marianobilli/bluetooth-radio-manager/hardware/Radio-module-NRF24L01-PA-LNA-with-antenna-Packaging-status-original.jpg

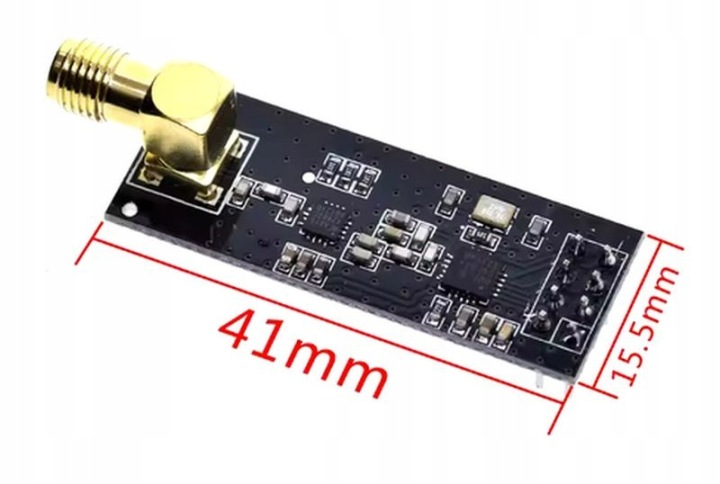
hardware/Radio-module-NRF24L01-PA-LNA-with-antenna-Packaging-status-original.jpg
