marianobilli/bluetooth-radio-manager/images/board-underside.png

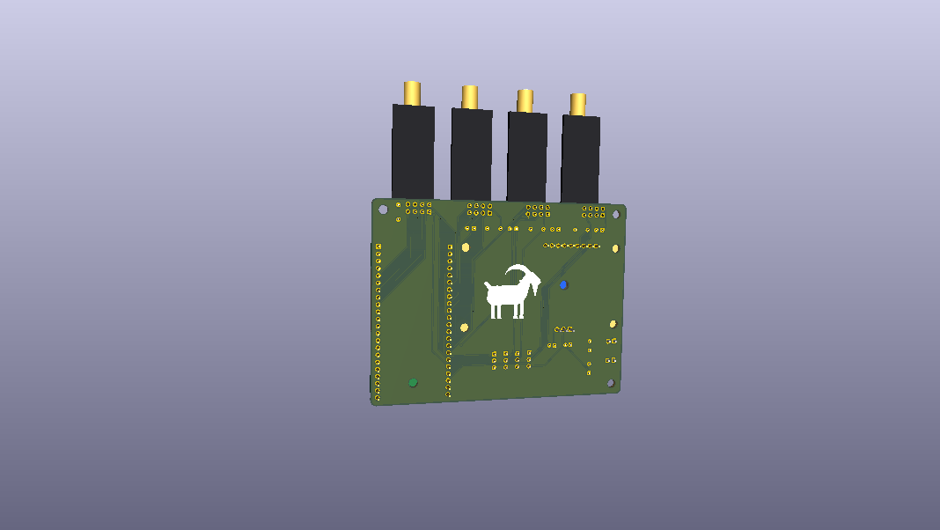
images/board-underside.png
