marianobilli/bluetooth-radio-manager/images/ebyte e01.png

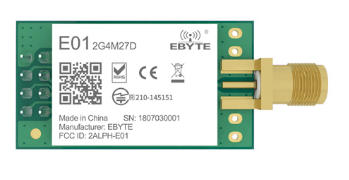
images/ebyte e01.png
