marianobilli/bluetooth-radio-manager/images/usb-port-for-case.png

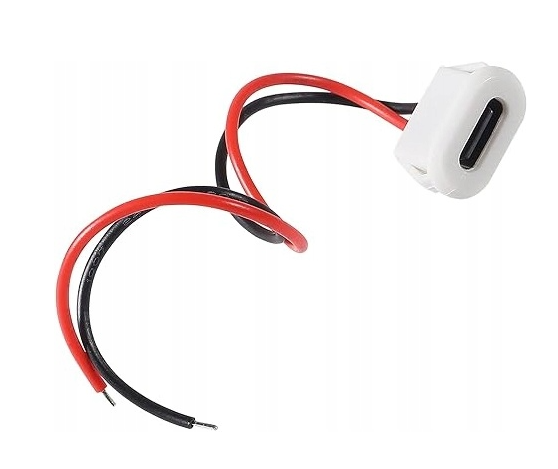
images/usb-port-for-case.png
