marianobilli/bluetooth-radio-manager/case/print/enclosure_lid.step

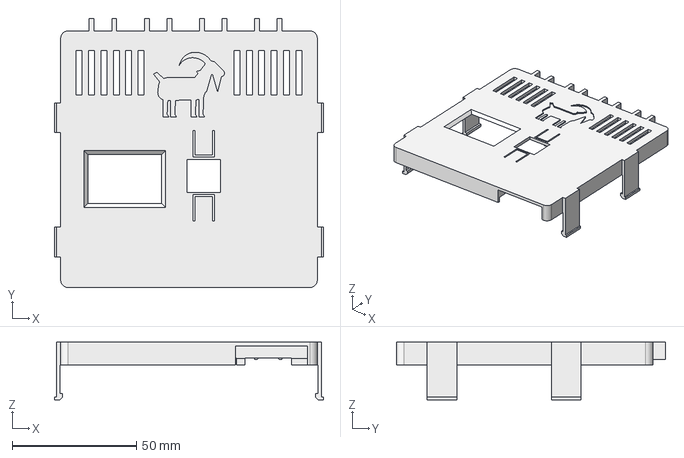
[picture p10: CAD file, 2026-10-19]
case/print/enclosure_lid.step
108.3 x 108.3 x 23.2 mm
