marianobilli/bluetooth-radio-manager/case/print/enclosure_base.step

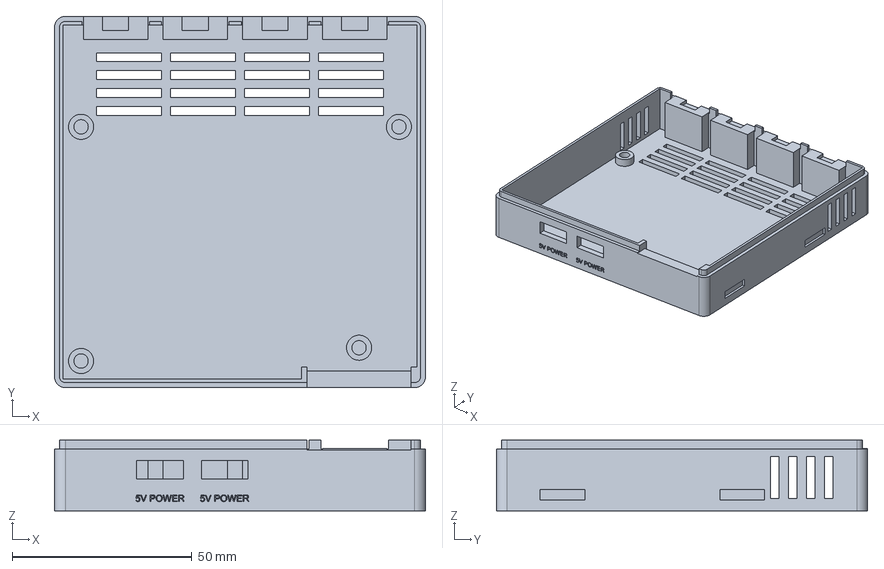
[picture p11: CAD file, 2026-10-19]
case/print/enclosure_base.step
103.3 x 103.3 x 19.7 mm
