marianobilli/bluetooth-radio-manager/(list of files, cad)

Other CAD files:
case/print/enclosure_base.stl
case/print/enclosure_lid.stl
