marianobilli/bluetooth-radio-manager/hardware/kicad/bt_radio_manager.kicad_pcb

## KiCad design hardware/kicad/bt_radio_manager.kicad_pcb (2026-10-15)

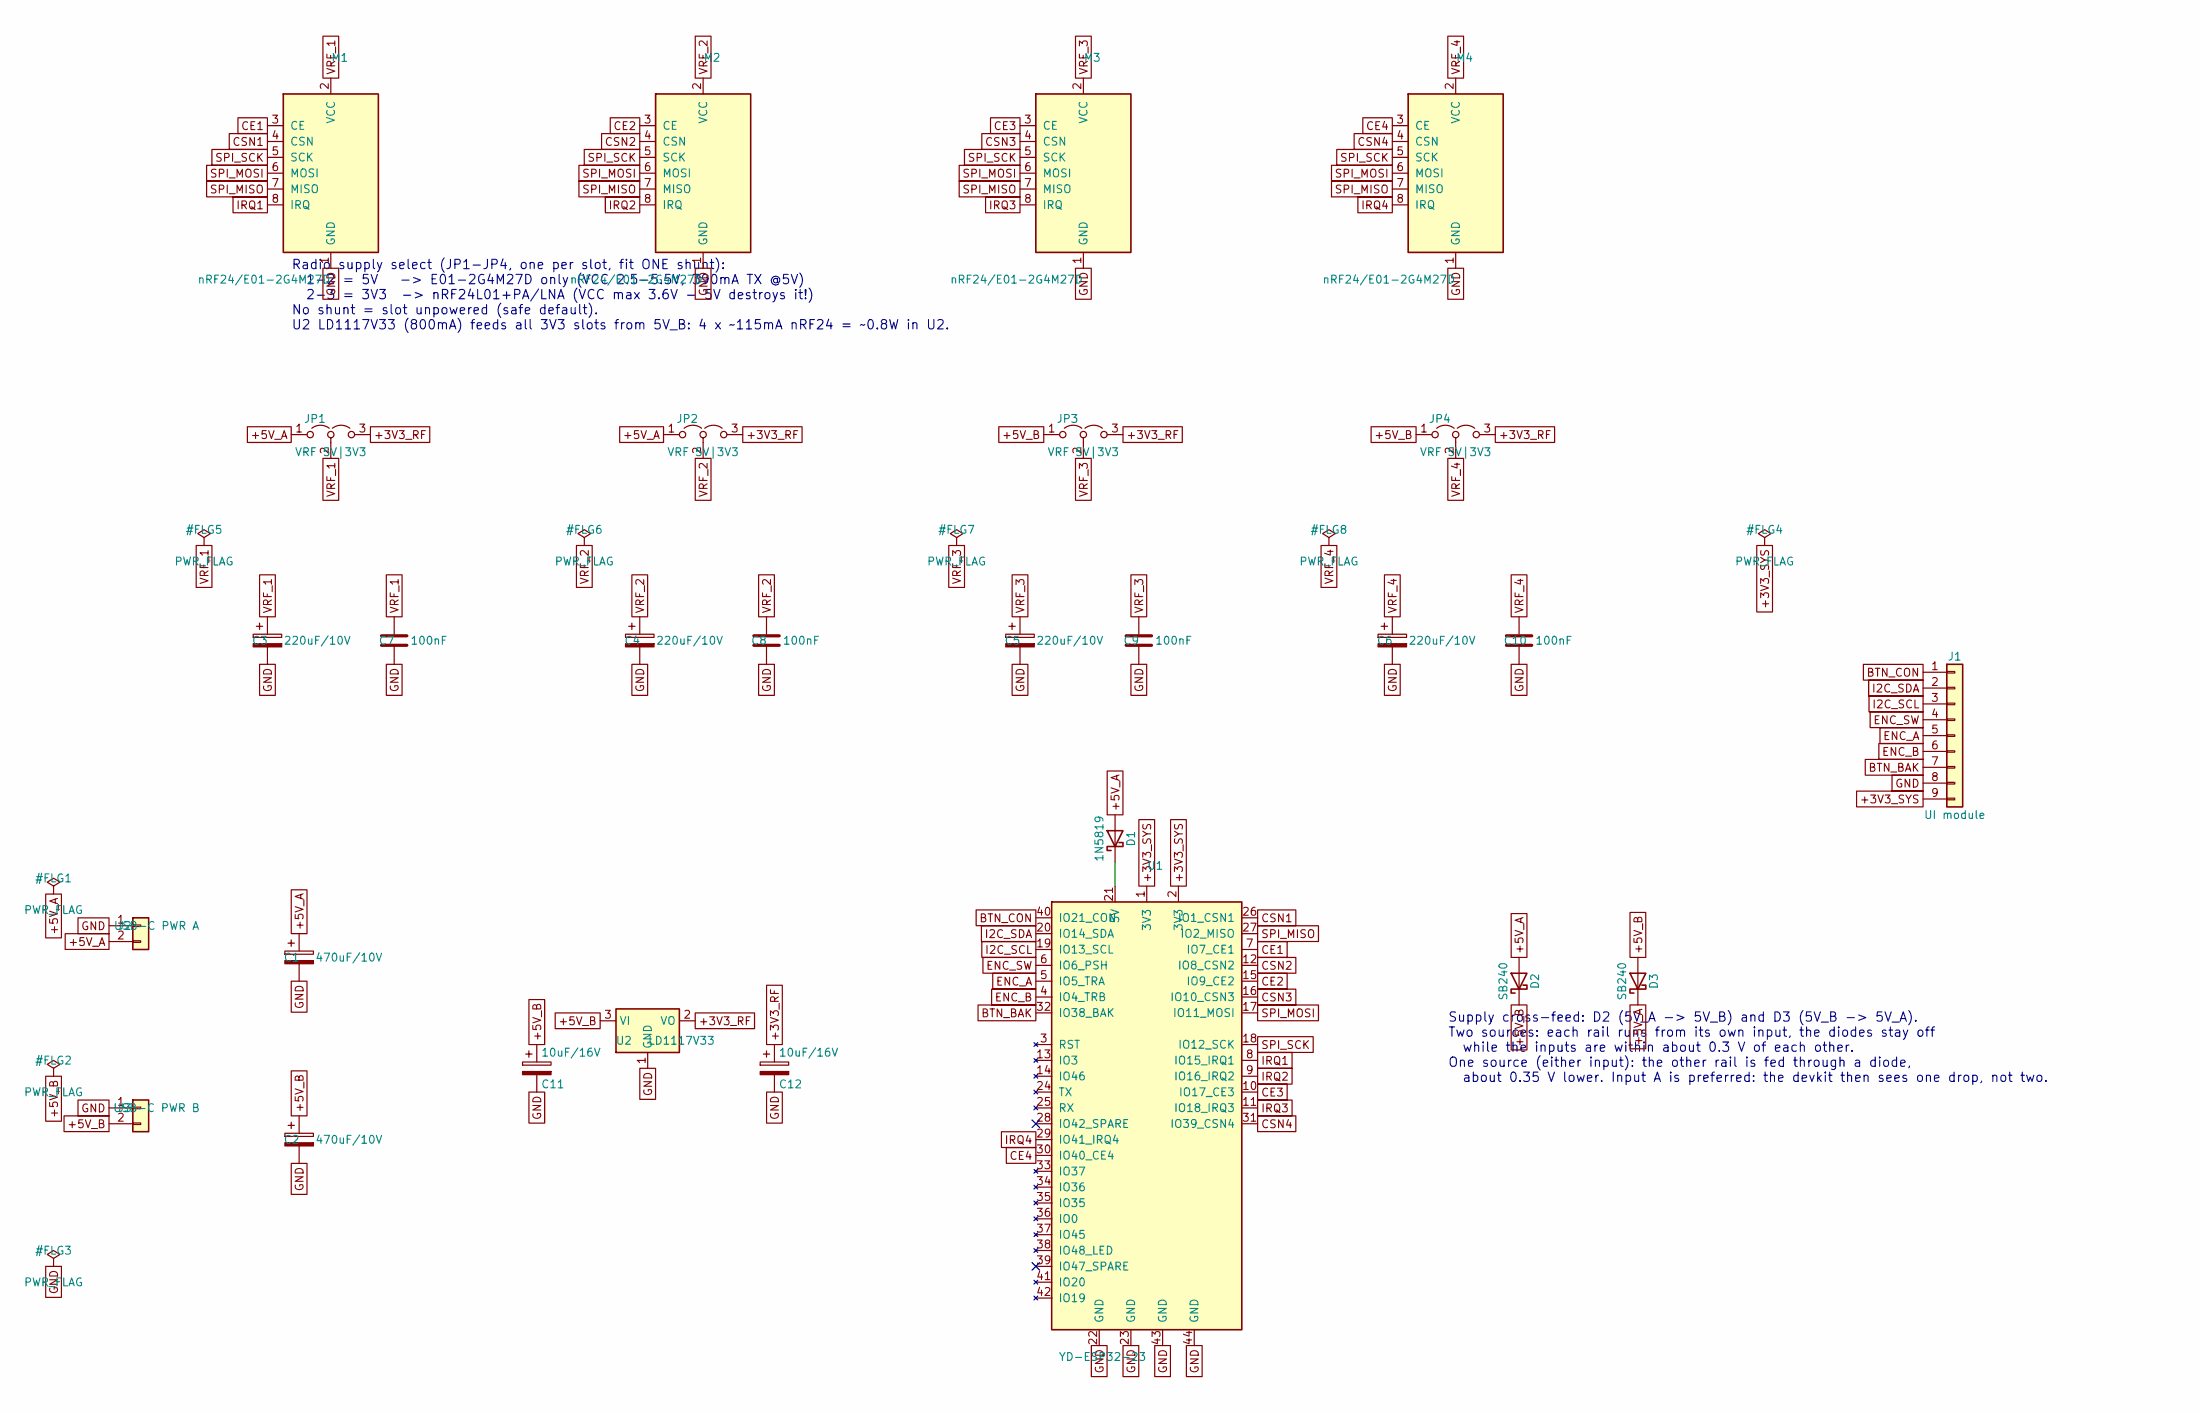
[picture p12: schematic bt_radio_manager.kicad_sch]

Parts:
C1, C2: 470uF/10V; CP_Radial_D8.0mm_P3.50mm
C3, C4, C5, C6: 220uF/10V; CP_Radial_D6.3mm_P2.50mm
C7, C8, C9, C10: 100nF; C_Disc_D5.0mm_W2.5mm_P5.00mm
C11, C12: 10uF/16V; CP_Radial_D5.0mm_P2.00mm
D1: 1N5819; D_DO-41_SOD81_P10.16mm_Horizontal
D2, D3: SB240; D_DO-15_P10.16mm_Horizontal
J1: UI module; UI_module_OLED_EC11
J2: USB-C PWR A; JST_XH_B2B-XH-A_1x02_P2.50mm_Vertical
J3: USB-C PWR B; JST_XH_B2B-XH-A_1x02_P2.50mm_Vertical
JP1, JP2, JP3, JP4: VRF 5V|3V3; PinHeader_1x03_P2.54mm_Vertical
M1, M2, M3, M4: nRF24/E01-2G4M27D; nRF24_module_2x4
U1: YD-ESP32-23
U2: LD1117V33; TO-220-3_Horizontal_TabDown

Connections:
+3V3_RF: C12.1, JP1.3 (B), JP2.3 (B), JP3.3 (B), JP4.3 (B), U2.2 (VO)
+3V3_SYS: J1.9, U1.1 (3V3), U1.2 (3V3)
+5V_A: C1.1, D1.2 (A), D2.2 (A), D3.1 (K), J2.2, JP1.1 (A), JP2.1 (A)
+5V_B: C2.1, C11.1, D2.1 (K), D3.2 (A), J3.2, JP3.1 (A), JP4.1 (A), U2.3 (VI)
BTN_BAK: J1.7, U1.32 (IO38_BAK)
BTN_CON: J1.1, U1.40 (IO21_CON)
CE1: M1.3 (CE), U1.7 (IO7_CE1)
CE2: M2.3 (CE), U1.15 (IO9_CE2)
CE3: M3.3 (CE), U1.10 (IO17_CE3)
CE4: M4.3 (CE), U1.30 (IO40_CE4)
CSN1: M1.4 (CSN), U1.26 (IO1_CSN1)
CSN2: M2.4 (CSN), U1.12 (IO8_CSN2)
CSN3: M3.4 (CSN), U1.16 (IO10_CSN3)
CSN4: M4.4 (CSN), U1.31 (IO39_CSN4)
ENC_A: J1.5, U1.5 (IO5_TRA)
ENC_B: J1.6, U1.4 (IO4_TRB)
ENC_SW: J1.4, U1.6 (IO6_PSH)
GND: C1.2, C2.2, C3.2, C4.2, C5.2, C6.2, C7.2, C8.2, C9.2, C10.2, C11.2, C12.2, J1.8, J2.1, J3.1, M1.1 (GND), M2.1 (GND), M3.1 (GND), M4.1 (GND), U1.22 (GND), U1.23 (GND), U1.43 (GND), U1.44 (GND), U2.1 (GND)
I2C_SCL: J1.3, U1.19 (IO13_SCL)
I2C_SDA: J1.2, U1.20 (IO14_SDA)
IRQ1: M1.8 (IRQ), U1.8 (IO15_IRQ1)
IRQ2: M2.8 (IRQ), U1.9 (IO16_IRQ2)
IRQ3: M3.8 (IRQ), U1.11 (IO18_IRQ3)
IRQ4: M4.8 (IRQ), U1.29 (IO41_IRQ4)
unnamed: D1.1 (K), U1.21 (5V)
SPI_MISO: M1.7 (MISO), M2.7 (MISO), M3.7 (MISO), M4.7 (MISO), U1.27 (IO2_MISO)
SPI_MOSI: M1.6 (MOSI), M2.6 (MOSI), M3.6 (MOSI), M4.6 (MOSI), U1.17 (IO11_MOSI)
SPI_SCK: M1.5 (SCK), M2.5 (SCK), M3.5 (SCK), M4.5 (SCK), U1.18 (IO12_SCK)
VRF_1: C3.1, C7.1, JP1.2 (C), M1.2 (VCC)
VRF_2: C4.1, C8.1, JP2.2 (C), M2.2 (VCC)
VRF_3: C5.1, C9.1, JP3.2 (C), M3.2 (VCC)
VRF_4: C6.1, C10.1, JP4.2 (C), M4.2 (VCC)

Notes on the sheet:
Radio supply select (JP1-JP4, one per slot, fit ONE shunt): 1-2 = 5V -> E01-2G4M27D only (VCC 2.5-5.5V, 390mA TX @5V) 2-3 = 3V3 -> nRF24L01+PA/LNA (VCC max 3.6V - 5V destroys it!) No shunt = slot unpowered (safe default). U2 LD1117V33 (800mA) feeds all 3V3 slots from 5V_B: 4 x ~115mA nRF24 = ~0.8W 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
Supply cross-feed: D2 (5V_A -> 5V_B) and D3 (5V_B -> 5V_A). Two sources: each rail runs from its own input, the diodes stay off while the inputs are within about 0.3 V of each other. One source (either input): the other rail is fed through a diode, about 0.35 V lower. Input A is preferred: the devk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

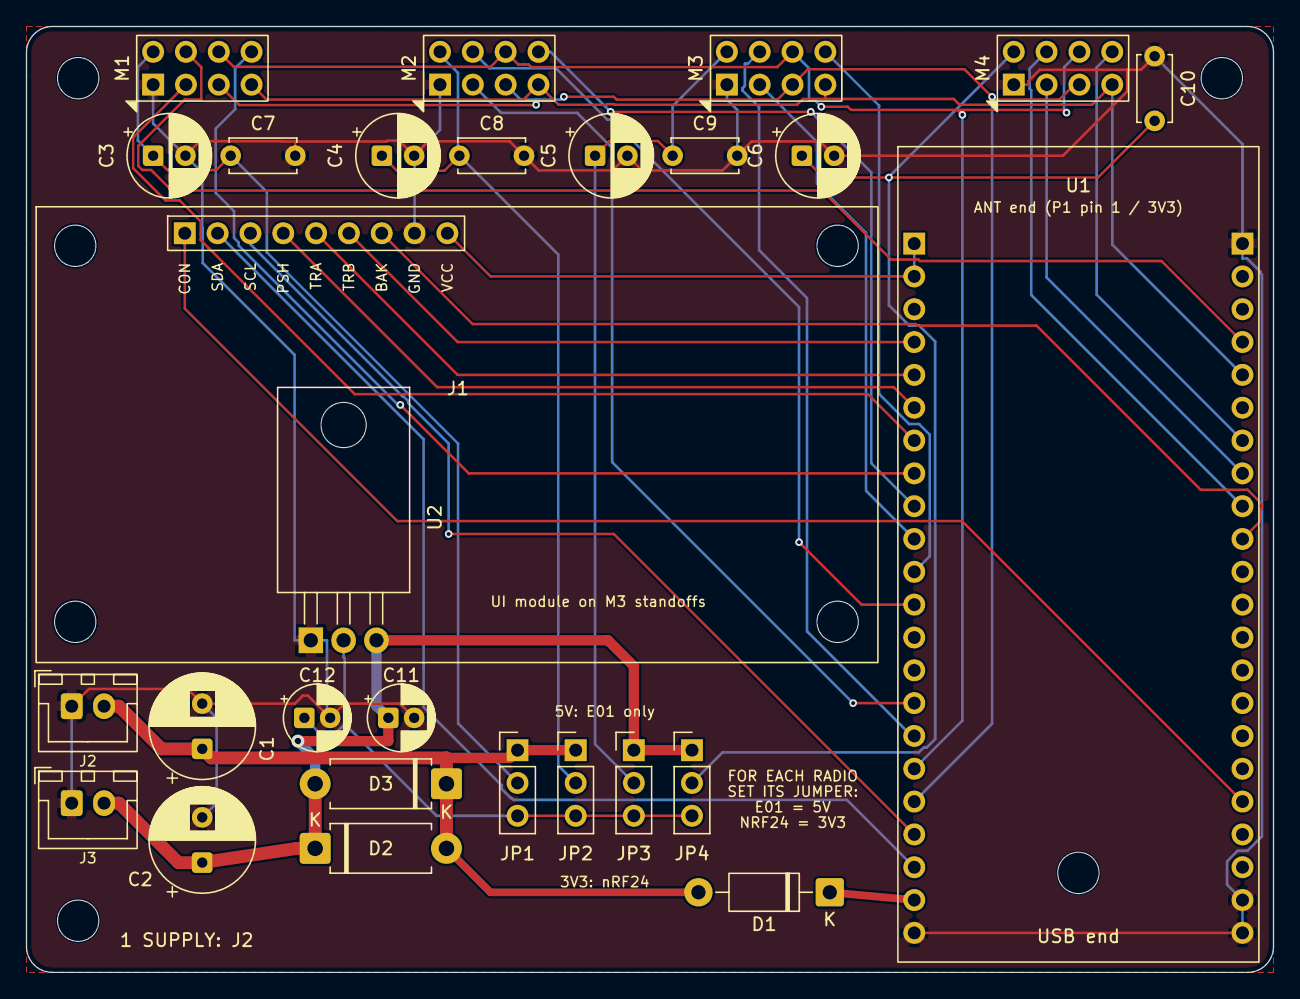
[picture p13: board bt_radio_manager.kicad_pcb from above]

Board: 2 copper layers, 96.5 x 73.2 mm, 32 parts (0 on the bottom side), 32 nets.

Other parts of the board:
MH1, MH2, MH3, MH4: MountingHole_3.2mm; MountingHole_3.2mm_M3
