marianobilli/bluetooth-radio-manager/bt_resiliency_tester2.png

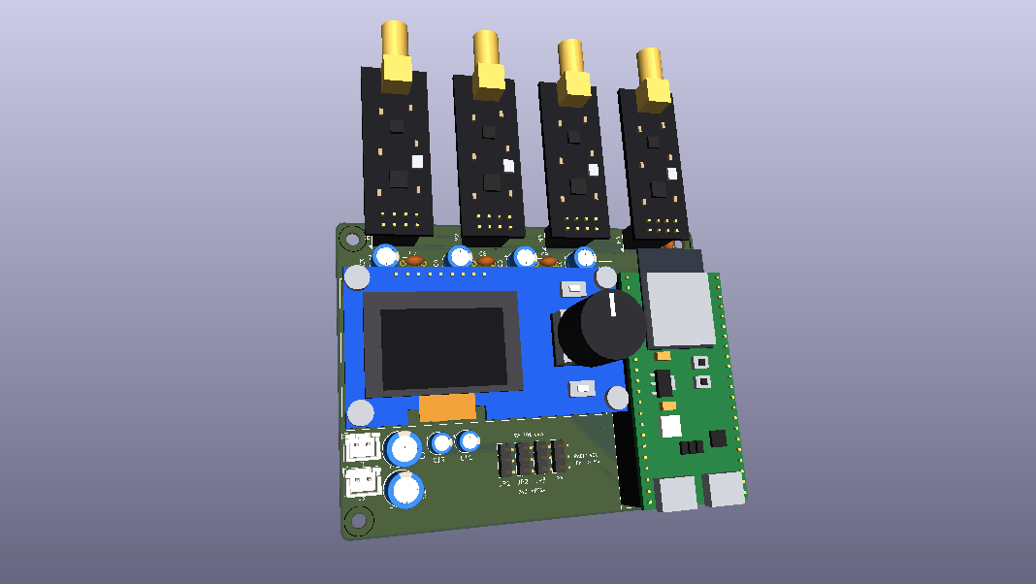
bt_resiliency_tester2.png
