marianobilli/bluetooth-radio-manager/(commit log)

2026-10-13 Initial commit based on esp32-hello-world
2026-10-13 Add KiCad hardware design, fab outputs and hardware README
    - KiCad 10 schematic + PCB (96.5 x 73.2 mm, 2-layer): 4 radio slots
    (nRF24L01+PA+LNA or E01-2G4M27D) on the top edge with bodies off-board,
    YD-ESP32-23 devkit, OLED/encoder UI module, two 5V JST-XH inputs
    - Per-slot 5V/3V3 radio supply jumpers with a shared LD1117V33 (mounted
    flat under the UI module), replacing the four buck modules
    - Custom footprints and generated STEP models (radio, buck, ESP32, UI),
    goat logo on the bottom silkscreen
    - Gerber + drill outputs and fab zip
    - README: components, radio modules, jumper settings, pin map, power
    budget and design decisions, with KiCad 3D renders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
2026-10-14 Add D1 to isolate the devkit's USB power, clearer silkscreen, v0.1 mark
    The YD-ESP32-23 passes its USB VBUS out through its 5 V pin, so plugging
    the devkit into a PC for programming also powered any E01 radio jumpered
    to 5 V on slots 1-2 from the PC port. D1 (1N5819, DO-41) now sits between
    +5V_A and the devkit 5 V pin: the USB port feeds only the devkit, and in
    battery mode the devkit sees about 4.7 V, fine for its regulator. Radios
    still get the full 5 V.
    Silkscreen: replace the "RADIO VCC / JPn -> Mn" label with plain wording
    (set each radio's jumper: E01 = 5V, NRF24 = 3V3) and add a mirrored
    "v0.1" under the goat on the back.
    Gerbers, drill files and the fab zip are re-exported with Ki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
2026-10-14 Enclosure: USB-C sockets, snap latches, vents, engraving, coloured models
    case/enclosure.py (build123d) grows from the screwed-lid tray into the
    current design:
    - Two panel-mount USB-C power sockets (2-wire pigtails to J2/J3) in the
    front wall next to the ESP32 USB bay. Measured 13 x 5.11 snap-in body,
    15.7 x 9 oval flange; the socket is modelled, shown in the viewer,
    included in the clearance check and exported as usb_socket_2pin.step.
    The left-wall cable notch is now off by default.
    - Lid fastening by four snap latches, two per side wall, instead of M3
    screws through corner columns. Flexible tabs on the lid hook into
    pockets in the base wall; pull a side's tabs out to open. Th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
2026-10-14 README: new board and enclosure renders, enclosure section
2026-10-14 Rename project to Bluetooth Radio Manager
    KiCad project files move from bt_resiliency_tester.* to bt_radio_manager.*
    with their internal references updated (project meta, sheet name, symbol
    instance paths, board title, footprint sheet files). Gerbers, drill files,
    the fab zip and the DRC report are regenerated under the new name.
    README title, image references and file tables updated; the underside
    render moves to images/board-underside.png and the unreferenced old top
    render is dropped. The case script points at the renamed board file.
    The footprint/symbol library keeps its bt_tester_parts name.
2026-10-14 Rename project: update references inside the KiCad project files
2026-10-14 Enclosure print files in case/print and ordering guidance in the README
    The case script now also writes the base and lid as STL and STEP into
    case/print/, which is tracked, so the files to upload to a print service
    are in the repo. README gains a section on what to order: process and
    material (PA12 nylon or PETG; no resin, the latches need to flex), FDM
    settings and orientation, tolerances, and the inserts, screws and USB
    sockets to buy alongside.
2026-10-14 README: condensed, reorganised around overview, PCB, PCB order, case order, firmware
2026-10-14 E01-2G4M27D model, E01 board variant, one case for both radios with SMA guides
    - make_e01_2g4m27d.py generates the E01-2G4M27D module and antenna STEP models
    from measurements and the manual (docs/); E01_module_2x4 footprint carries them
    - bt_radio_manager_e01.kicad_pcb: same layout with the E01 in the four sockets,
    for 3D viewing and the case fit check
    - enclosure.py: back wall placed for the E01's edge SMA, 18 mm notches and
    support blocks with pockets for its lower SMA legs, deck raised over its
    shield can; guide ribs on the lid straddle each jack's square section so a
    module cannot swing sideways; both board variants are clearance-checked and
    `enclosure.py [nrf24|e01]` picks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
2026-10-14 Case: engrave "5V POWER" under each USB-C power socket
    Label in the base front wall under each socket flange, 2.6 mm font, 0.4 mm
    deep, as the USB_SOCK_LABEL_* parameters in enclosure.py. Print files
    regenerated.
2026-10-15 Case: flat-top lid so both parts print without supports
    The lid's deck sat 2.85 mm below the raised ESP32 strip, with the logo and
    button caps standing proud of it, so printed deck-down most of the top hung
    in the air and needed supports. The deck now sits at the strip's height as
    one flat plane: logo engraved 0.6 mm instead of in relief, button pads
    flush. Outer size unchanged; knob clearance drops to about 0.75 mm.
    README print settings updated, including seam placement on the latch tabs.
2026-10-15 Power: D2/D3 cross-feed so one 5V supply or two both work, v0.2
    Two SB240 Schottkys (DO-15) join +5V_A and +5V_B in opposite
    directions. With two supplies each rail runs from its own input; with
    one (preferably J2) the other rail is fed through a diode. The 5V
    power traces, previously 0.2 mm, are re-routed at 0.6-1.0 mm for the
    ~1.9 A single-supply case. Diodes placed clear of the USB-C socket
    bodies (case clearance check passes for both radio variants).
    Both board variants updated, gerbers and order zip re-exported,
    README power section and BOM updated, version mark bumped to v0.2.
2026-10-15 README: FDM printing instructions for the case, knob fitting note
    Settings table for the printer (lid upside down, no supports, 4 perimeters,
    seam on the latch tab edges) with the reasons, and a note to fit the encoder
    knob about 1 mm high now that it clears the flat lid by 0.75 mm.
2026-10-15 README: re-render case images with the flat-top lid
    Hero view and both back-wall close-ups recaptured from the OCP viewer with
    the new lid; the two close-ups share one framing and the same width.
2026-10-19 Case: attach the lid snap-latch tabs to the lid wall
    The tabs sat LATCH_GAP (0.3 mm) outside the lid wall over their full
    height, so nothing joined them to the lid: the lid exported as 5 solids
    and the tabs printed loose. Fill that gap above the split line, 1 mm into
    the wall; below the split the tab keeps its clearance to the base and
    flexes as before. Lid STEP/STL now a single solid.
